jh-elec/SuperClokk/READ_ME!!!.jpg

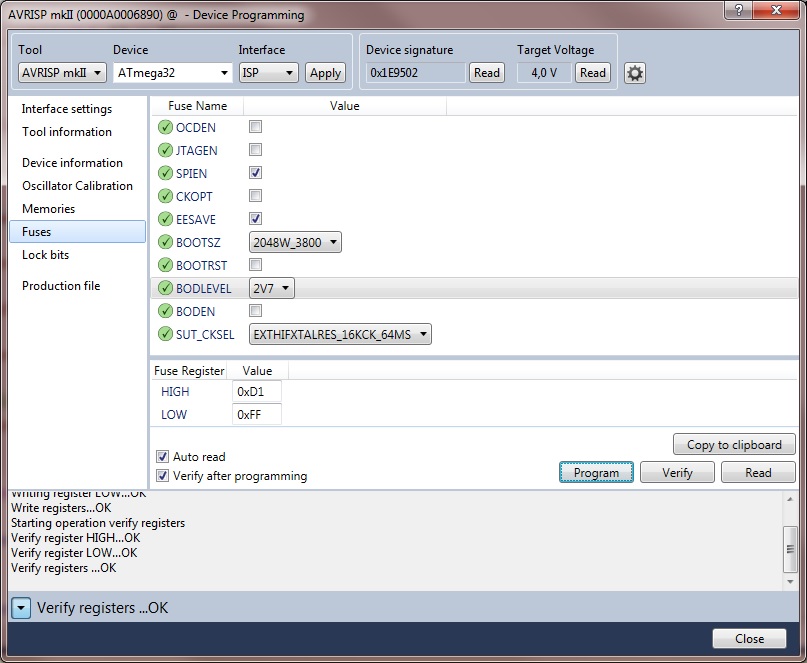
READ_ME!!!.jpg
