jh-elec/SuperClokk/super_clokk/Praesentation/SuperClokk_Front_Board_Screenshot.jpg

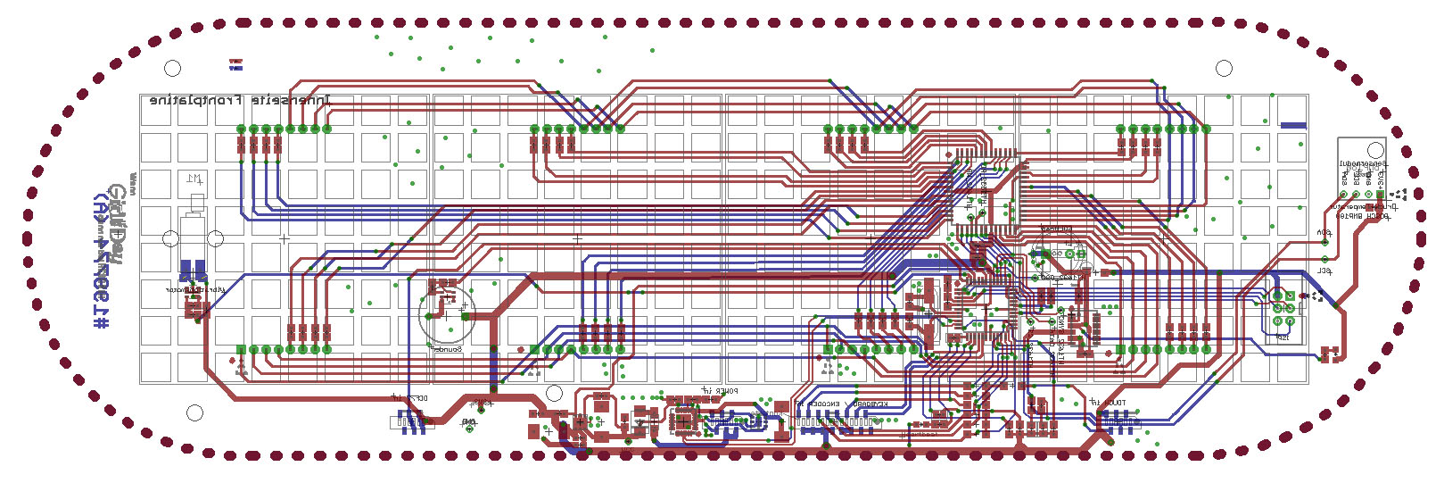
super_clokk/Praesentation/SuperClokk_Front_Board_Screenshot.jpg
