jh-elec/SuperClokk/README.md

# SuperClokk
   8 x 8 LED Matrix Uhr
 
 - BMP180  ( Luftdruck / Temperatur )
 - RX8564  ( RTC - Echtzeituhr )
 - DCF77   ( Uhrzeit  Funkempfänger )
