jh-elec/SuperClokk/super_clokk/CAD Daten/Super_Clokk_199774_2015_03_30.brd

## EAGLE design super_clokk/CAD Daten/Super_Clokk_199774_2015_03_30.brd (2018-07-22)

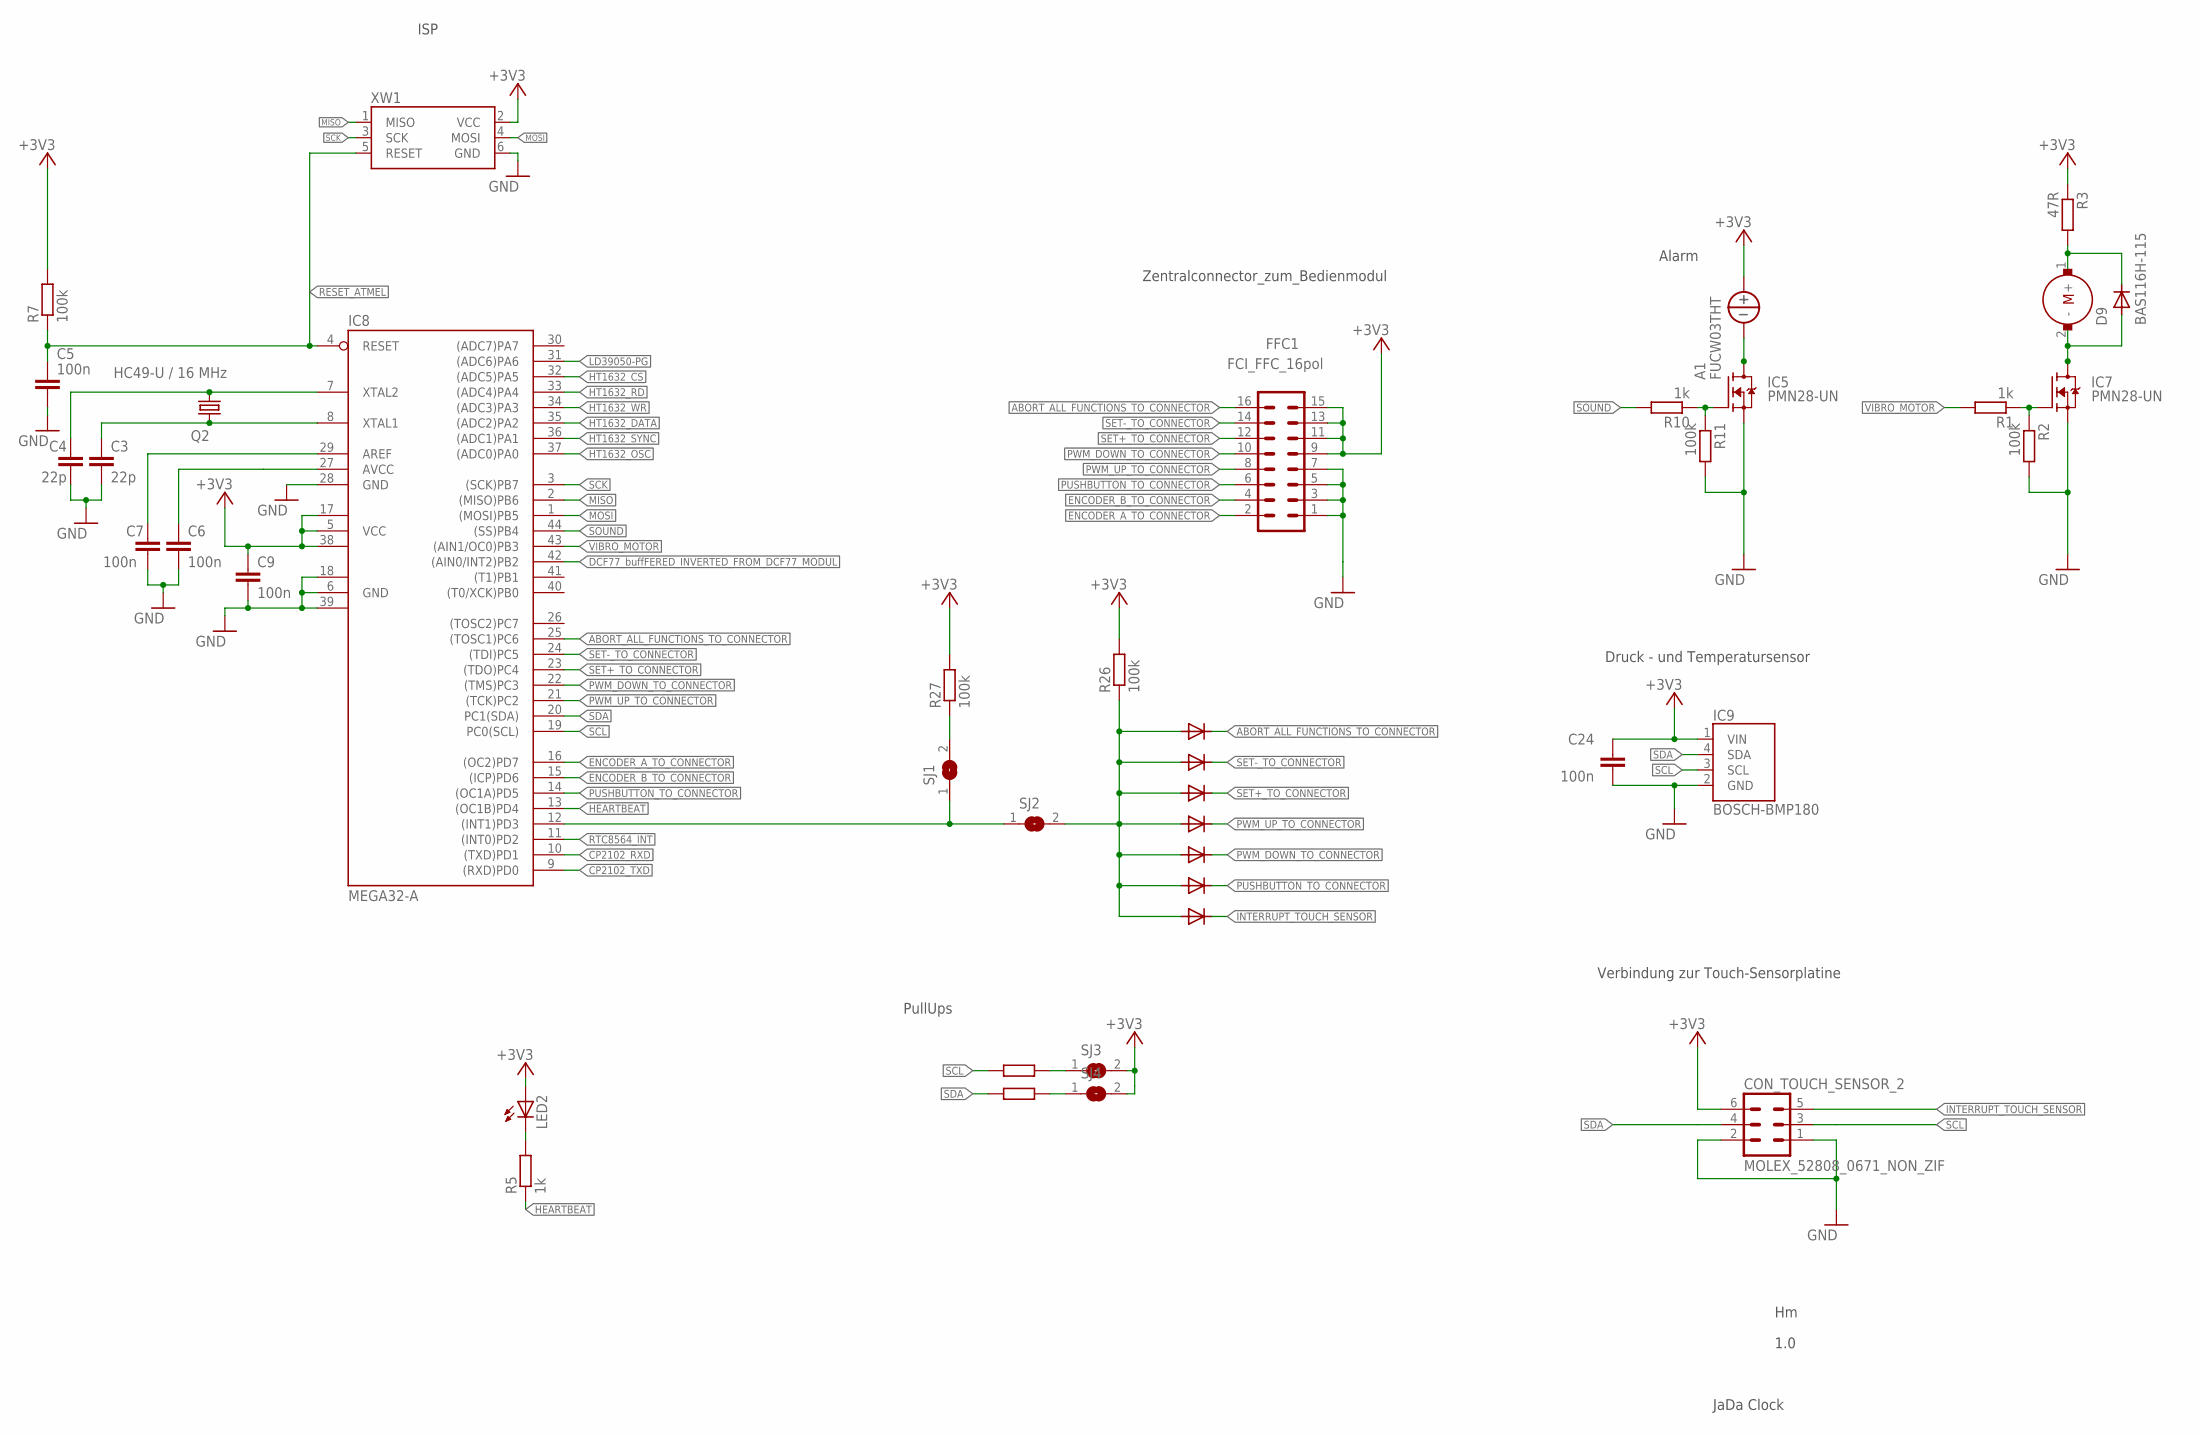
[picture p4: schematic Super_Clokk_199774_2015_03_30.sch, sheet 2]

Parts:
A1: FUCW03THT; FUCW03
C3, C4: 22p; C0805K
C5, C6, C7, C9, C24: 100n; C0805
CON_TOUCH_SENSOR_2: MOLEX_52808_0671_NON_ZIF; MOLEX_52808-0671_NON_ZIF
D2, D3, D4, D5, D6, D8, D9, D10: BAS116H-115; SOD123
FFC1: FCI_FFC_16pol; MOLEX_52808_1671_NON_ZIF
IC5, IC7: PMN28-UN; SOT457
IC8: MEGA32-A; TQFP44
IC9: BOSCH-BMP180; 10X13MM
LED2: LEDCHIPLED_0805; CHIPLED_0805
M1: VIBROMOTORTHT432A; LA4-432A
Q2: HC49-U / 16 MHz; HC49
R1, R5, R10: 1k; R0805
R2, R7, R11, R26, R27: 100k; R0805
R3: 47R; R0805
R52, R53: 4,7k; R0805
SJ1, SJ2, SJ3, SJ4: SJ
XW1: WSL6; WSL

Connections:
+3V3: A1.+, C9.1, C24.1, CON_TOUCH_SENSOR_2.6, FFC1.9, FFC1.11, FFC1.13, FFC1.15, IC8.5 (VCC), IC8.17 (VCC1), IC8.38 (VCC2), IC9.1 (VIN), LED2.A, R3.1, R7.2, R26.2, R27.2, SJ3.2, SJ4.2, XW1.2 (VCC); also elsewhere on the board
ABORT_ALL_FUNCTIONS_TO_CONNECTOR: D2.C, FFC1.16, IC8.25 ((TOSC1)PC6)
AREF: C7.1, IC8.29 (AREF)
AVCC: C6.1, IC8.27 (AVCC)
CP2102_RXD: IC8.10 ((TXD)PD1); also elsewhere on the board
CP2102_TXD: IC8.9 ((RXD)PD0); also elsewhere on the board
DCF77_buffFERED_INVERTED_FROM_DCF77_MODUL: IC8.42 ((AIN0/INT2)PB2); also elsewhere on the board
EINGABE?: D2.A, D3.A, D4.A, D5.A, D6.A, D8.A, D10.A, R26.1, SJ2.2
ENCODER_A_TO_CONNECTOR: FFC1.2, IC8.16 ((OC2)PD7)
ENCODER_B_TO_CONNECTOR: FFC1.4, IC8.15 ((ICP)PD6)
GND: C3.2, C4.2, C5.2, C6.2, C7.2, C9.2, C24.2, CON_TOUCH_SENSOR_2.1, CON_TOUCH_SENSOR_2.2, FFC1.1, FFC1.3, FFC1.5, FFC1.7, IC5.4 (S), IC7.4 (S), IC8.6 (GND), IC8.18 (GND1), IC8.28 (GND), IC8.39 (GND2), IC9.2 (GND), R2.2, R11.2, XW1.6 (GND); also elsewhere on the board
HEARTBEAT: IC8.13 ((OC1B)PD4), R5.1
HT1632_CS: IC8.32 ((ADC5)PA5); also elsewhere on the board
HT1632_DATA: IC8.35 ((ADC2)PA2); also elsewhere on the board
HT1632_OSC: IC8.37 ((ADC0)PA0); also elsewhere on the board
HT1632_RD: IC8.33 ((ADC4)PA4); also elsewhere on the board
HT1632_SYNC: IC8.36 ((ADC1)PA1); also elsewhere on the board
HT1632_WR: IC8.34 ((ADC3)PA3); also elsewhere on the board
INTERRUPT_TOUCH_SENSOR: CON_TOUCH_SENSOR_2.5, D8.C
LD39050-PG: IC8.31 ((ADC6)PA6); also elsewhere on the board
MISO: IC8.2 ((MISO)PB6), XW1.1 (MISO)
MOSI: IC8.1 ((MOSI)PB5), XW1.4 (MOSI)
unnamed: A1.-, IC5.1 (D), IC5.2 (D), IC5.5 (D), IC5.6 (D)
unnamed: R52.2, SJ3.1
unnamed: R53.2, SJ4.1
unnamed: IC7.3 (G), R1.1, R2.1
unnamed: D9.A, IC7.1 (D), IC7.2 (D), IC7.5 (D), IC7.6 (D), M1.2 (-)
unnamed: D9.C, M1.1 (+), R3.2
unnamed: IC5.3 (G), R10.1, R11.1
unnamed: LED2.C, R5.2
unnamed: IC8.12 ((INT1)PD3), SJ1.1, SJ2.1
unnamed: R27.1, SJ1.2
PUSHBUTTON_TO_CONNECTOR: D6.C, FFC1.6, IC8.14 ((OC1A)PD5)
PWM_DOWN_TO_CONNECTOR: D10.C, FFC1.10, IC8.22 ((TMS)PC3)
PWM_UP_TO_CONNECTOR: D5.C, FFC1.8, IC8.21 ((TCK)PC2)
RESET_ATMEL: C5.1, IC8.4 (RESET), R7.1, XW1.5 (RESET)
RTC8564_INT: IC8.11 ((INT0)PD2); also elsewhere on the board
SCK: IC8.3 ((SCK)PB7), XW1.3 (SCK)
SCL: CON_TOUCH_SENSOR_2.3, IC8.19 (PC0(SCL)), IC9.3 (SCL), R52.1; also elsewhere on the board
SDA: CON_TOUCH_SENSOR_2.4, IC8.20 (PC1(SDA)), IC9.4 (SDA), R53.1; also elsewhere on the board
SET+_TO_CONNECTOR: D4.C, FFC1.12, IC8.23 ((TDO)PC4)
SET-_TO_CONNECTOR: D3.C, FFC1.14, IC8.24 ((TDI)PC5)
SOUND: IC8.44 ((SS)PB4), R10.2
VIBRO_MOTOR: IC8.43 ((AIN1/OC0)PB3), R1.2
XTAL_1: C3.1, IC8.8 (XTAL1), Q2.1
XTAL_2: C4.1, IC8.7 (XTAL2), Q2.2

Notes on the sheet:
1.0
JaDa Clock
Alarm
PullUps
Druck - und Temperatursensor
ISP
Zentralconnector_zum_Bedienmodul
Verbindung zur Touch-Sensorplatine

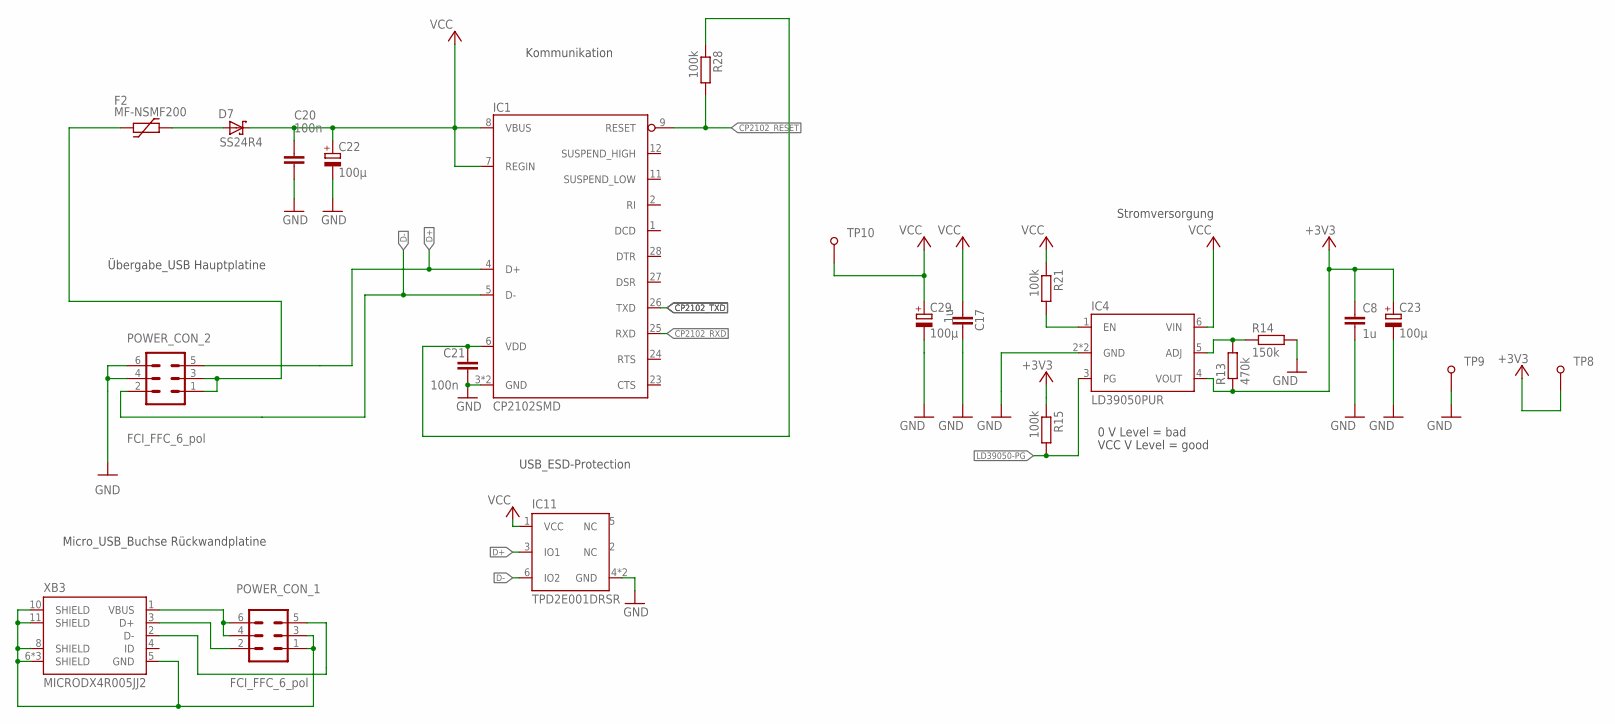
[picture p5: schematic Super_Clokk_199774_2015_03_30.sch, sheet 3]

Parts:
C8, C17: 1u; C0805K
C20, C21: 100n; C0805
C22, C23, C29: 100µ; SMC_D
D7: SS24R4; DO-214AA/SMB
F2: MF-NSMF200; 1206L
IC1: CP2102SMD; QFN28
IC4: LD39050PUR; DFN6
IC11: TPD2E001DRSR; DRS
POWER_CON_1, POWER_CON_2: FCI_FFC_6_pol; MOLEX_52808-0671_NON_ZIF
R13: 470k; R0603
R14: 150k; R0603
R15, R21, R28: 100k; R0805
TP8, TP9, TP10: PAD´S8; THT-1X2,54
XB3: MICRODX4R005JJ2; MICRO_NEU

Connections:
+3V3: C8.1, C23.+, IC4.4 (VOUT), R13.1, R15.1, TP8.TP; also elsewhere on the board
CP2102_RESET: IC1.9 (RESET), R28.2
CP2102_RXD: IC1.25 (RXD); also elsewhere on the board
CP2102_TXD: IC1.26 (TXD); also elsewhere on the board
D+: IC1.4 (D+), IC11.3 (IO1), POWER_CON_2.5
D-: IC1.5 (D-), IC11.6 (IO2), POWER_CON_2.2
GND: C8.2, C17.2, C20.2, C21.2, C22.-, C23.-, C29.-, IC1.3 (GND), IC1.THERMAL (GND), IC4.2 (GND), IC4.EXP (GND), IC11.4 (GND), IC11.THERMAL (GND), POWER_CON_2.4, POWER_CON_2.6, R14.2, TP9.TP; also elsewhere on the board
GND_USB_RüCKWAND: POWER_CON_1.1, POWER_CON_1.3, XB3.5 (GND), XB3.6 (SHIELD), XB3.7 (SHIELD), XB3.8 (SHIELD), XB3.9 (SHIELD), XB3.10 (SHIELD), XB3.11 (SHIELD)
LD39050-PG: IC4.3 (PG), R15.2; also elsewhere on the board
unnamed: C21.1, IC1.6 (VDD), R28.1
unnamed: D7.A, F2.2
unnamed: IC4.1 (EN), R21.2
unnamed: IC4.5 (ADJ), R13.2, R14.1
POWER_FROM_USB_RüCKWAND: F2.1, POWER_CON_2.1, POWER_CON_2.3
USB_D+: POWER_CON_1.2, XB3.3 (D+)
USB_D-: POWER_CON_1.5, XB3.2 (D-)
VBUS_USB_RüCKWAND: POWER_CON_1.4, POWER_CON_1.6, XB3.1 (VBUS)
VCC: C17.1, C20.1, C22.+, C29.+, D7.C, IC1.7 (REGIN), IC1.8 (VBUS), IC4.6 (VIN), IC11.1 (VCC), R21.1, TP10.TP

Notes on the sheet:
Kommunikation
0 V Level = bad
VCC V Level = good
Stromversorgung
USB_ESD-Protection
Micro_USB_Buchse Rückwandplatine
Übergabe_USB Hauptplatine

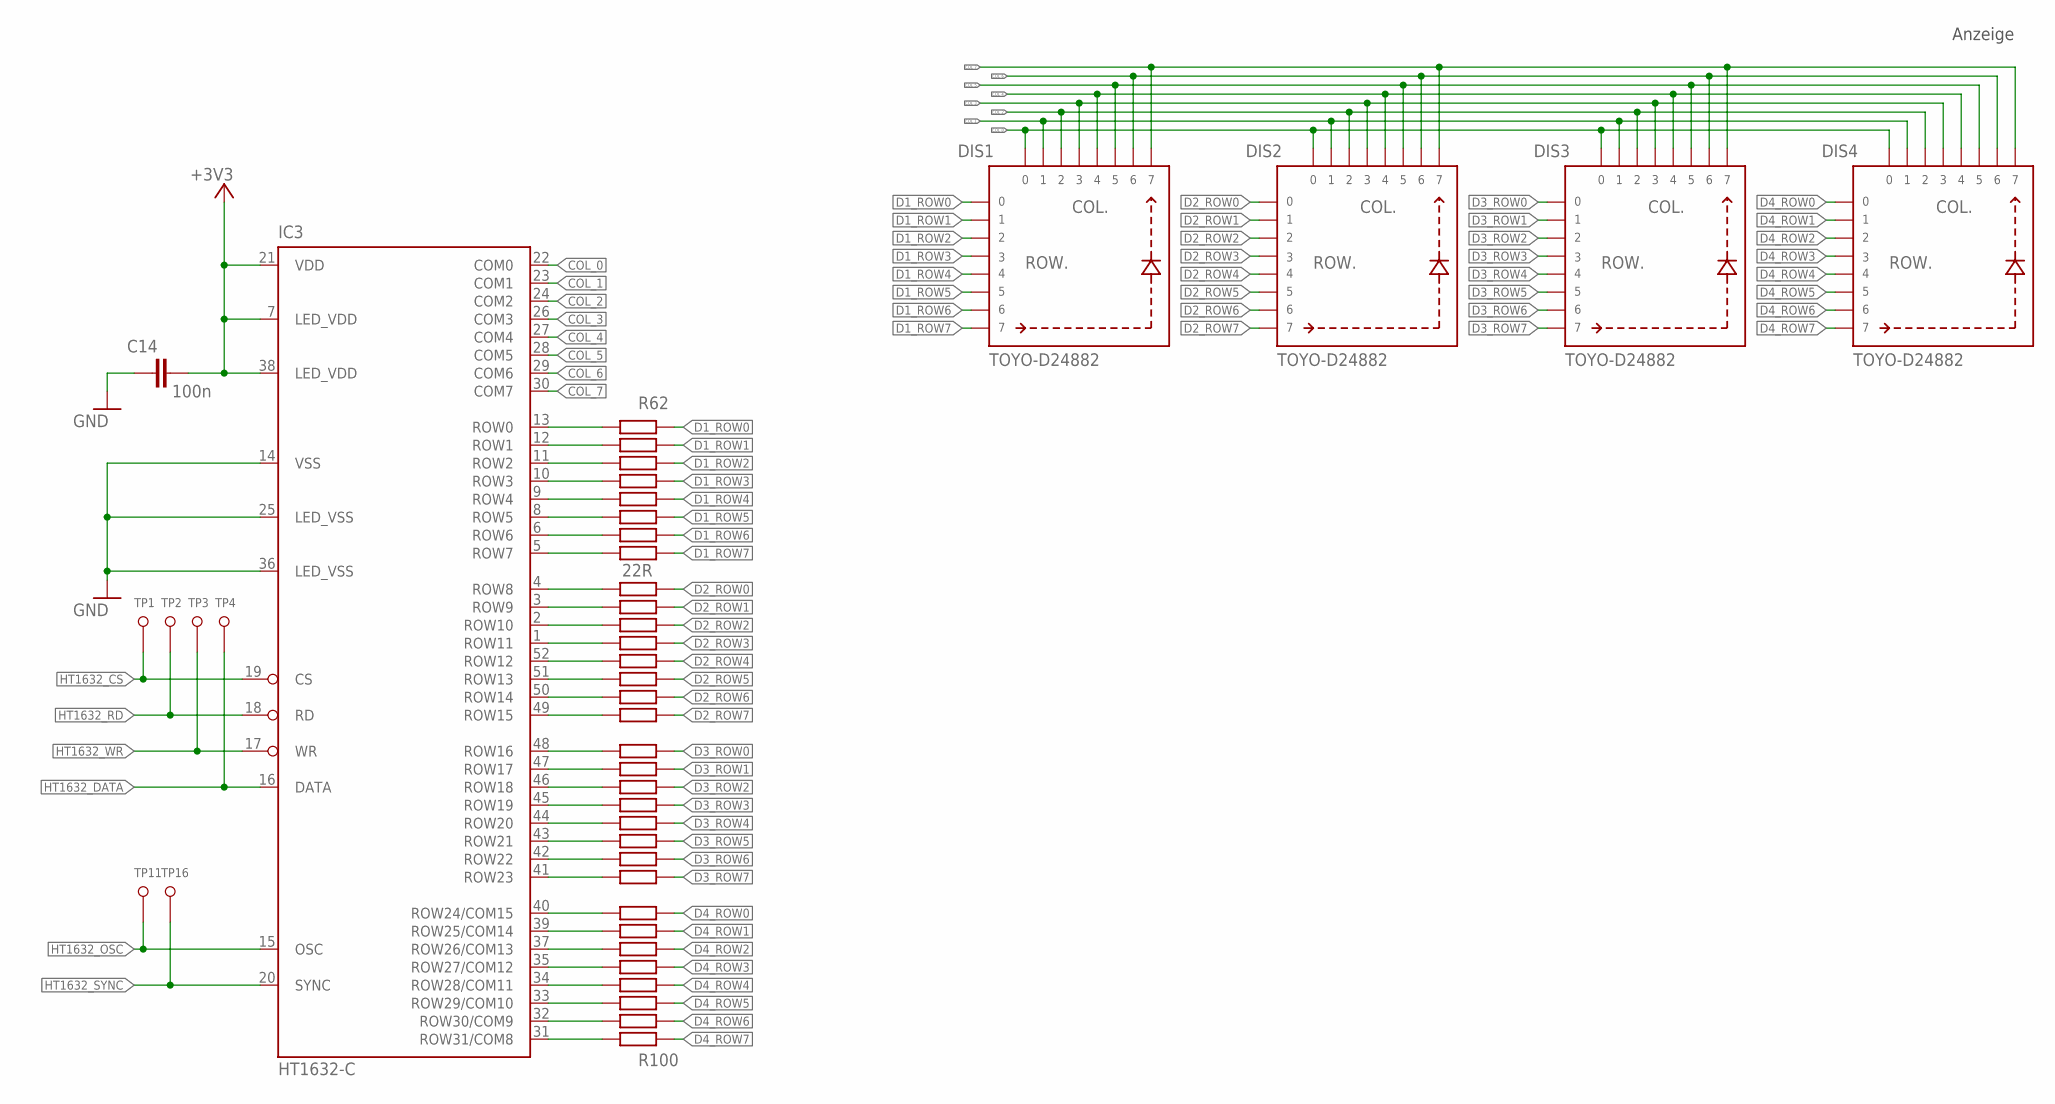
[picture p6: schematic Super_Clokk_199774_2015_03_30.sch, sheet 4]

Parts:
C14: 100n; C0805
DIS1, DIS2, DIS3, DIS4: TOYO-D24882; TOYO
IC3: HT1632-C; 52PIN_OFP
R62, R63, R65, R66, R67, R74, R75, R76, R77, R78, R79, R80, R81, R82, R83, R84, R85, R86, R87, R88, R89, R90, R91, R92, R93, R94, R95, R96, R97, R98, R99, R100: 22R; R0805
TP1, TP2, TP3, TP4, TP11, TP16: PAD´S8; THT-1X2,54

Connections:
+3V3: C14.2, IC3.7 (LED_VDD), IC3.21 (VDD), IC3.38 (LED_VDD); also elsewhere on the board
COL_0: DIS1.1, DIS2.1, DIS3.1, DIS4.1, IC3.22 (COM0)
COL_1: DIS1.2, DIS2.2, DIS3.2, DIS4.2, IC3.23 (COM1)
COL_2: DIS1.3, DIS2.3, DIS3.3, DIS4.3, IC3.24 (COM2)
COL_3: DIS1.4, DIS2.4, DIS3.4, DIS4.4, IC3.26 (COM3)
COL_4: DIS1.12, DIS2.12, DIS3.12, DIS4.12, IC3.27 (COM4)
COL_5: DIS1.11, DIS2.11, DIS3.11, DIS4.11, IC3.28 (COM5)
COL_6: DIS1.10, DIS2.10, DIS3.10, DIS4.10, IC3.29 (COM6)
COL_7: DIS1.9, DIS2.9, DIS3.9, DIS4.9, IC3.30 (COM7)
D1_ROW0: DIS1.16, R62.1
D1_ROW1: DIS1.15, R63.1
D1_ROW2: DIS1.14, R65.1
D1_ROW3: DIS1.13, R66.1
D1_ROW4: DIS1.5, R67.1
D1_ROW5: DIS1.6, R74.1
D1_ROW6: DIS1.7, R75.1
D1_ROW7: DIS1.8, R76.1
D2_ROW0: DIS2.16, R77.1
D2_ROW1: DIS2.15, R78.1
D2_ROW2: DIS2.14, R79.1
D2_ROW3: DIS2.13, R80.1
D2_ROW4: DIS2.5, R81.1
D2_ROW5: DIS2.6, R82.1
D2_ROW6: DIS2.7, R83.1
D2_ROW7: DIS2.8, R84.1
D3_ROW0: DIS3.16, R85.1
D3_ROW1: DIS3.15, R86.1
D3_ROW2: DIS3.14, R87.1
D3_ROW3: DIS3.13, R88.1
D3_ROW4: DIS3.5, R89.1
D3_ROW5: DIS3.6, R90.1
D3_ROW6: DIS3.7, R91.1
D3_ROW7: DIS3.8, R92.1
D4_ROW0: DIS4.16, R93.1
D4_ROW1: DIS4.15, R94.1
D4_ROW2: DIS4.14, R95.1
D4_ROW3: DIS4.13, R96.1
D4_ROW4: DIS4.5, R97.1
D4_ROW5: DIS4.6, R98.1
D4_ROW6: DIS4.7, R99.1
D4_ROW7: DIS4.8, R100.1
GND: C14.1, IC3.14 (VSS), IC3.25 (LED_VSS), IC3.36 (LED_VSS); also elsewhere on the board
HT1632_CS: IC3.19 (CS), TP1.TP; also elsewhere on the board
HT1632_DATA: IC3.16 (DATA), TP4.TP; also elsewhere on the board
HT1632_OSC: IC3.15 (OSC), TP11.TP; also elsewhere on the board
HT1632_RD: IC3.18 (RD), TP2.TP; also elsewhere on the board
HT1632_SYNC: IC3.20 (SYNC), TP16.TP; also elsewhere on the board
HT1632_WR: IC3.17 (WR), TP3.TP; also elsewhere on the board
unnamed: IC3.13 (ROW0), R62.2
unnamed: IC3.12 (ROW1), R63.2
unnamed: IC3.11 (ROW2), R65.2
unnamed: IC3.10 (ROW3), R66.2
unnamed: IC3.9 (ROW4), R67.2
unnamed: IC3.8 (ROW5), R74.2
unnamed: IC3.6 (ROW6), R75.2
unnamed: IC3.5 (ROW7), R76.2
unnamed: IC3.4 (ROW8), R77.2
unnamed: IC3.3 (ROW9), R78.2
unnamed: IC3.2 (ROW10), R79.2
unnamed: IC3.1 (ROW11), R80.2
unnamed: IC3.52 (ROW12), R81.2
unnamed: IC3.51 (ROW13), R82.2
unnamed: IC3.50 (ROW14), R83.2
unnamed: IC3.49 (ROW15), R84.2
unnamed: IC3.48 (ROW16), R85.2
unnamed: IC3.47 (ROW17), R86.2
unnamed: IC3.46 (ROW18), R87.2
unnamed: IC3.45 (ROW19), R88.2
unnamed: IC3.44 (ROW20), R89.2
unnamed: IC3.43 (ROW21), R90.2
unnamed: IC3.42 (ROW22), R91.2
unnamed: IC3.41 (ROW23), R92.2
unnamed: IC3.40 (ROW24/COM15), R93.2
unnamed: IC3.39 (ROW25/COM14), R94.2
unnamed: IC3.37 (ROW26/COM13), R95.2
unnamed: IC3.35 (ROW27/COM12), R96.2
unnamed: IC3.34 (ROW28/COM11), R97.2
unnamed: IC3.33 (ROW29/COM10), R98.2
unnamed: IC3.32 (ROW30/COM9), R99.2
unnamed: IC3.31 (ROW31/COM8), R100.2

Notes on the sheet:
Anzeige

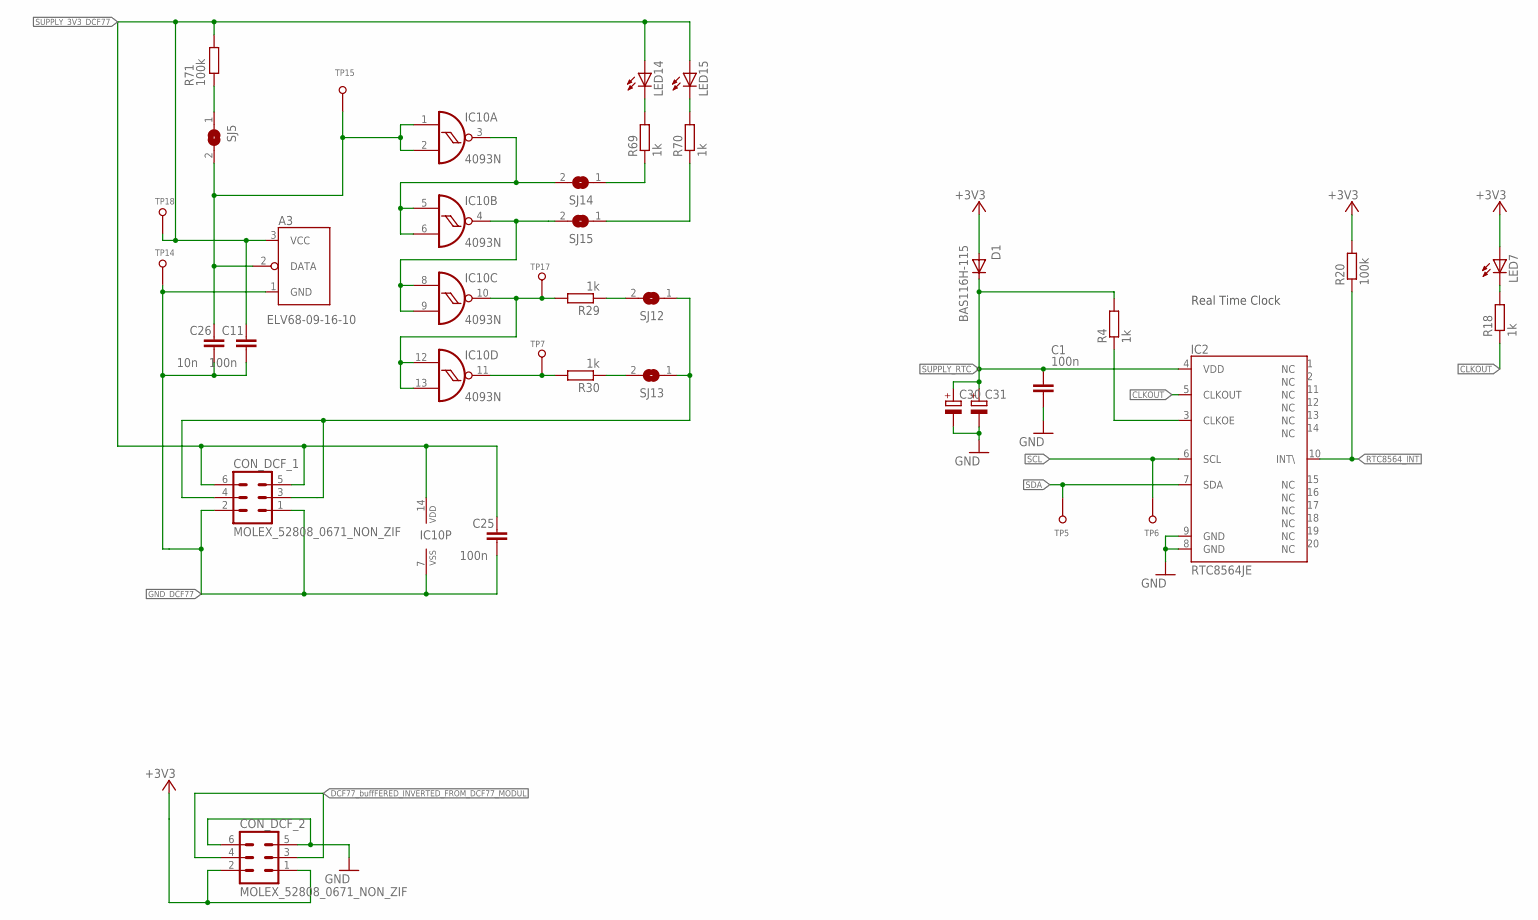
[picture p7: schematic Super_Clokk_199774_2015_03_30.sch, sheet 5]

Parts:
A3: ELV68-09-16-10; 18X23MM
C1, C11, C25: 100n; C0805
C26: 10n; C0805
C30: PANASONIC-EN&SD-SERIESTHT_1; PANASONIC_SD_SERIES_STEHEND
C31: PANASONIC-EN&SD-SERIESTHT; PANASONIC_SD_SERIES_LIEGEND
CON_DCF_1, CON_DCF_2: MOLEX_52808_0671_NON_ZIF; MOLEX_52808-0671_NON_ZIF
D1: BAS116H-115; SOD123
IC2: RTC8564JESMD; VSOJ20
IC10: 4093N; DIL14
LED7, LED14, LED15: LEDCHIPLED_0805; CHIPLED_0805
R4, R18, R29, R30, R69, R70: 1k; R0805
R20, R71: 100k; R0805
SJ5, SJ12, SJ13, SJ14, SJ15: SJ
TP5, TP6, TP7, TP14, TP15, TP17, TP18: PAD´S8; THT-1X2,54

Connections:
+3V3: CON_DCF_2.1, CON_DCF_2.2, D1.A, LED7.A, R20.2; also elsewhere on the board
CLKOUT: IC2.5 (CLKOUT), R18.1
DCF77_MODUL_OUT_INVERTED: A3.2 (DATA), C26.1, IC10.1 (I0), IC10.2 (I1), SJ5.2, TP15.TP
DCF77_buffFERED_INVERTED_FROM_DCF77_MODUL: CON_DCF_2.3, CON_DCF_2.4; also elsewhere on the board
DCF77_buffF_INVERTED: IC10.4 (O), IC10.8 (I0), IC10.9 (I1), SJ15.2
DCF77_buffF_NON_INVERTED: IC10.10 (O), IC10.12 (I0), IC10.13 (I1), R29.2, TP17.TP
DCF77_buffF_OUT_SWITCHABLE: CON_DCF_1.3, CON_DCF_1.4, SJ12.1, SJ13.1
GND: C1.2, C30.-, C31.MINUS (-), CON_DCF_2.5, CON_DCF_2.6, IC2.8 (GND), IC2.9 (GND); also elsewhere on the board
GND_DCF77: A3.1 (GND), C11.2, C25.2, C26.2, CON_DCF_1.1, CON_DCF_1.2, IC10.7 (VSS), TP14.TP
unnamed: R71.2, SJ5.1
unnamed: IC2.3 (CLKOE), R4.1
unnamed: IC10.3 (O), IC10.5 (I0), IC10.6 (I1), SJ14.2
unnamed: LED7.C, R18.2
unnamed: IC10.11 (O), R30.2, TP7.TP
unnamed: R29.1, SJ12.2
unnamed: R30.1, SJ13.2
unnamed: R69.1, SJ14.1
unnamed: R70.1, SJ15.1
unnamed: LED14.C, R69.2
unnamed: LED15.C, R70.2
RTC8564_INT: IC2.10 (INT\), R20.1; also elsewhere on the board
SCL: IC2.6 (SCL), TP6.TP; also elsewhere on the board
SDA: IC2.7 (SDA), TP5.TP; also elsewhere on the board
SUPPLY_3V3_DCF77: A3.3 (VCC), C11.1, C25.1, CON_DCF_1.5, CON_DCF_1.6, IC10.14 (VDD), LED14.A, LED15.A, R71.1, TP18.TP
SUPPLY_RTC: C1.1, C30.+, C31.PLUS (+), D1.C, IC2.4 (VDD), R4.2

Notes on the sheet:
Real Time Clock

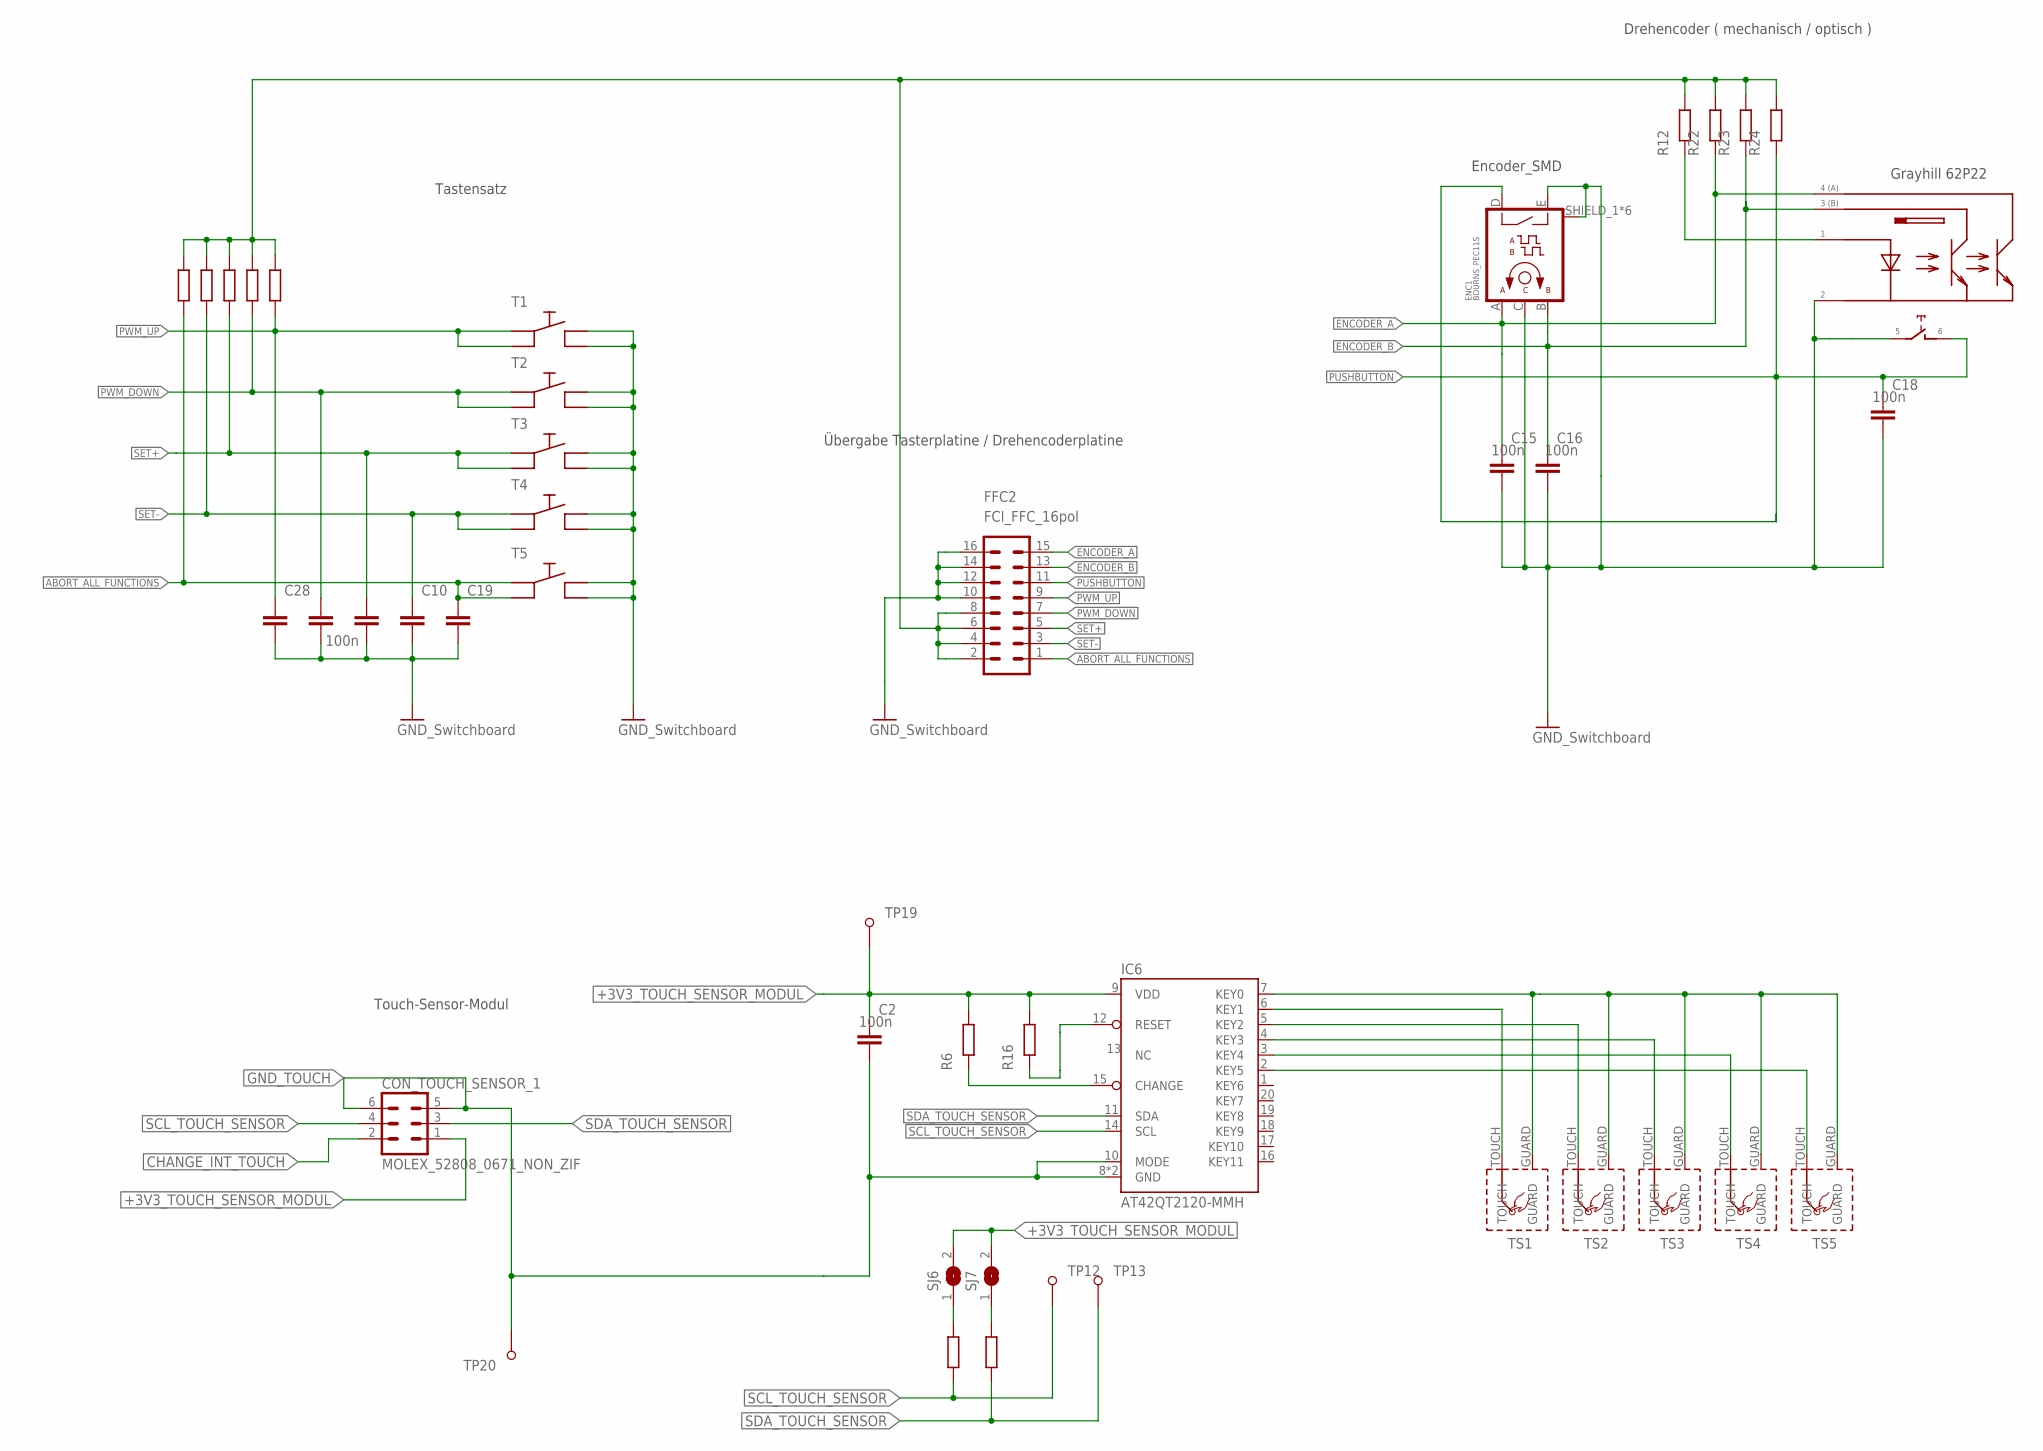
[picture p8: schematic Super_Clokk_199774_2015_03_30.sch, sheet 6]

Parts:
C2, C10, C12, C15, C16, C18, C19, C27, C28: 100n; C0805
CON_TOUCH_SENSOR_1: MOLEX_52808_0671_NON_ZIF; MOLEX_52808-0671_NON_ZIF
ENC1: BOURNS_PEC11S
ENC2: Grayhill 62P22; 62P22
FFC2: FCI_FFC_16pol; MOLEX_52808_1671_NON_ZIF
IC6: AT42QT2120-MMH; VQFN-20
R6, R16, R17, R19, R22, R23, R24: 10k; R0805
R8, R9, R25, R64, R72: 100k; R0805
R12: 100R; R0805
SJ6, SJ7: SJ
T1, T2, T3, T4, T5: OMRON-B3S-1002P; B3S-1002P
TP12, TP13, TP19, TP20: PAD´S8; THT-1X2,54
TS1, TS2, TS3, TS4, TS5: TOUCH_SENSOR_14MM

Connections:
+3V3_TOUCH_SENSOR_MODUL: C2.1, CON_TOUCH_SENSOR_1.1, IC6.9 (VDD), R6.2, R16.2, SJ6.2, SJ7.2, TP19.TP
ABORT_ALL_FUNCTIONS: C19.1, FFC2.1, R25.2, T5.1, T5.2
CHANGE_INT_TOUCH: CON_TOUCH_SENSOR_1.2, IC6.15 (CHANGE), R6.1
ENCODER_A: C15.1, ENC1.A, ENC2.4, FFC2.15, R22.1
ENCODER_B: C16.1, ENC1.B, ENC2.3, FFC2.13, R23.1
GND_SWITCHBOARD: C10.2, C12.2, C15.2, C16.2, C18.2, C19.2, C27.2, C28.2, ENC1.C, ENC1.E, ENC1.SHIELD_1, ENC1.SHIELD_2 (SHIELD_1), ENC1.SHIELD_3 (SHIELD_1), ENC1.SHIELD_4 (SHIELD_1), ENC1.SHIELD_5 (SHIELD_1), ENC1.SHIELD_6 (SHIELD_1), ENC2.2, ENC2.5 (1), FFC2.10, FFC2.12, FFC2.14, FFC2.16, T1.3, T1.4, T2.3, T2.4, T3.3, T3.4, T4.3, T4.4, T5.3, T5.4
GND_TOUCH: C2.2, CON_TOUCH_SENSOR_1.5, CON_TOUCH_SENSOR_1.6, IC6.8 (GND), IC6.10 (MODE), IC6.EXP. (GND), TP20.TP
unnamed: IC6.7 (KEY0), TS1.GUARD, TS2.GUARD, TS3.GUARD, TS4.GUARD, TS5.GUARD
unnamed: ENC2.1, R12.1
unnamed: IC6.12 (RESET), R16.1
unnamed: IC6.6 (KEY1), TS1.TOUCH
unnamed: IC6.5 (KEY2), TS2.TOUCH
unnamed: IC6.4 (KEY3), TS3.TOUCH
unnamed: IC6.3 (KEY4), TS4.TOUCH
unnamed: IC6.2 (KEY5), TS5.TOUCH
unnamed: R17.1, SJ6.1
unnamed: R19.1, SJ7.1
PUSHBUTTON: C18.1, ENC1.D, ENC2.6 (2), FFC2.11, R24.1
PWM_DOWN: C27.1, FFC2.7, R9.2, T2.1, T2.2
PWM_UP: C28.1, FFC2.9, R8.2, T1.1, T1.2
SCL_TOUCH_SENSOR: CON_TOUCH_SENSOR_1.4, IC6.14 (SCL), R17.2, TP12.TP
SDA_TOUCH_SENSOR: CON_TOUCH_SENSOR_1.3, IC6.11 (SDA), R19.2, TP13.TP
SET+: C12.1, FFC2.5, R64.2, T3.1, T3.2
SET-: C10.1, FFC2.3, R72.2, T4.1, T4.2
SUPPLY_3V3_BEDIENMODUL: FFC2.2, FFC2.4, FFC2.6, FFC2.8, R8.1, R9.1, R12.2, R22.2, R23.2, R24.2, R25.1, R64.1, R72.1

Notes on the sheet:
Encoder_SMD
Tastensatz
Übergabe Tasterplatine / Drehencoderplatine
Drehencoder ( mechanisch / optisch )
Touch-Sensor-Modul

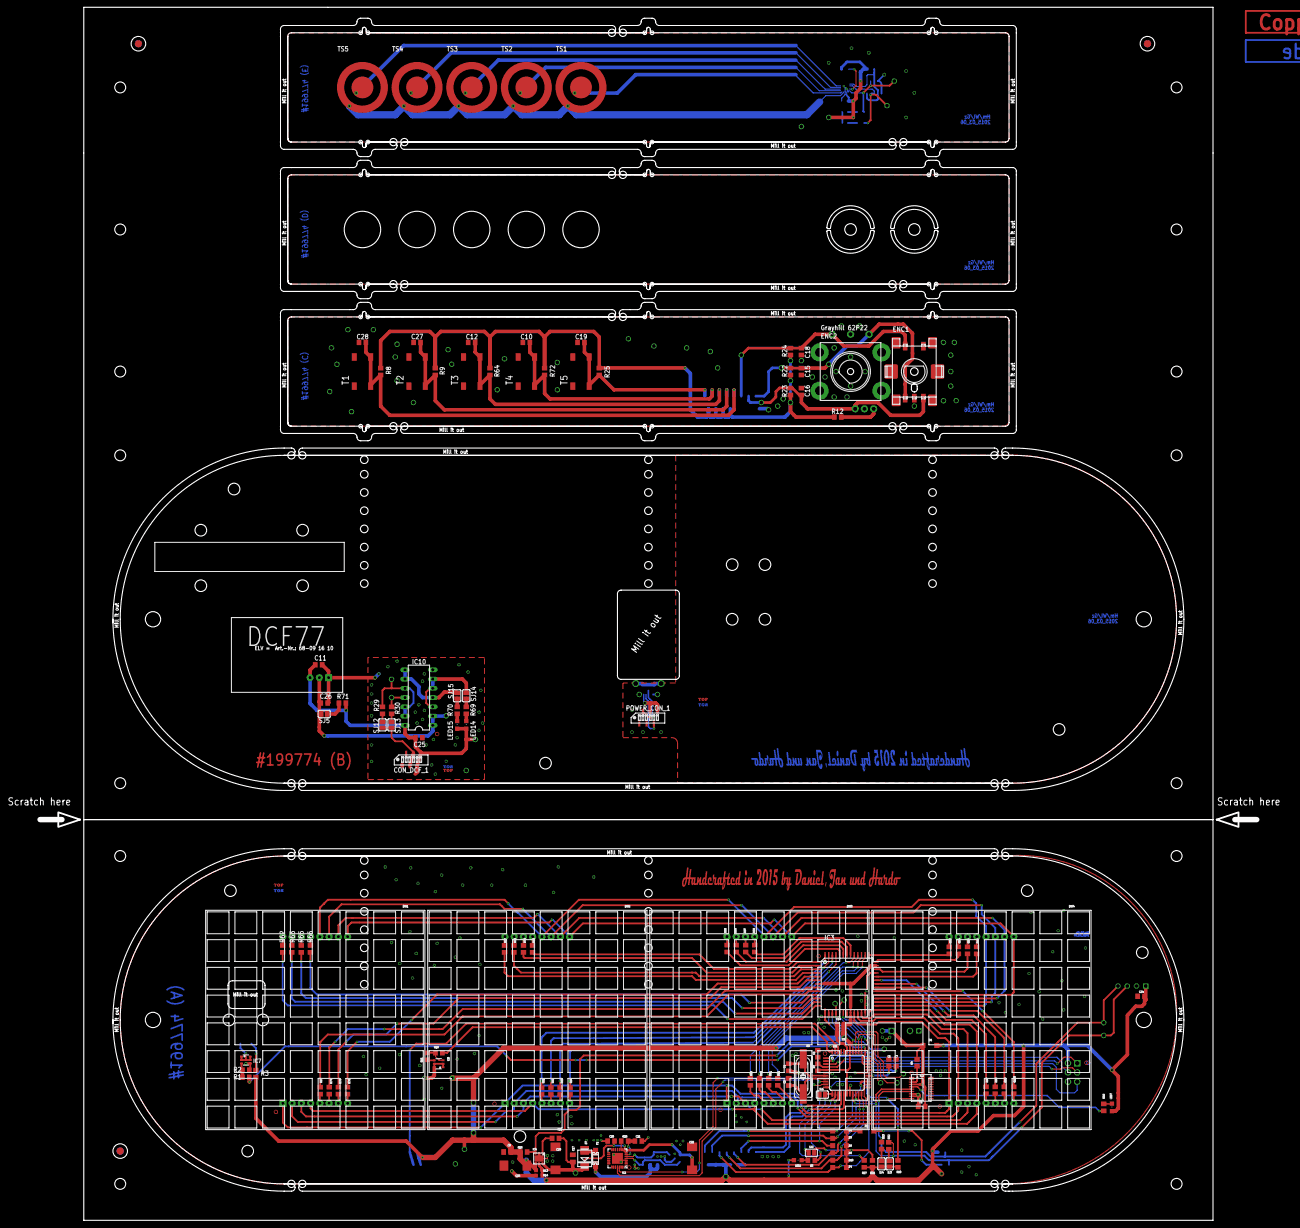
[picture p9: board Super_Clokk_199774_2015_03_30.brd from above]

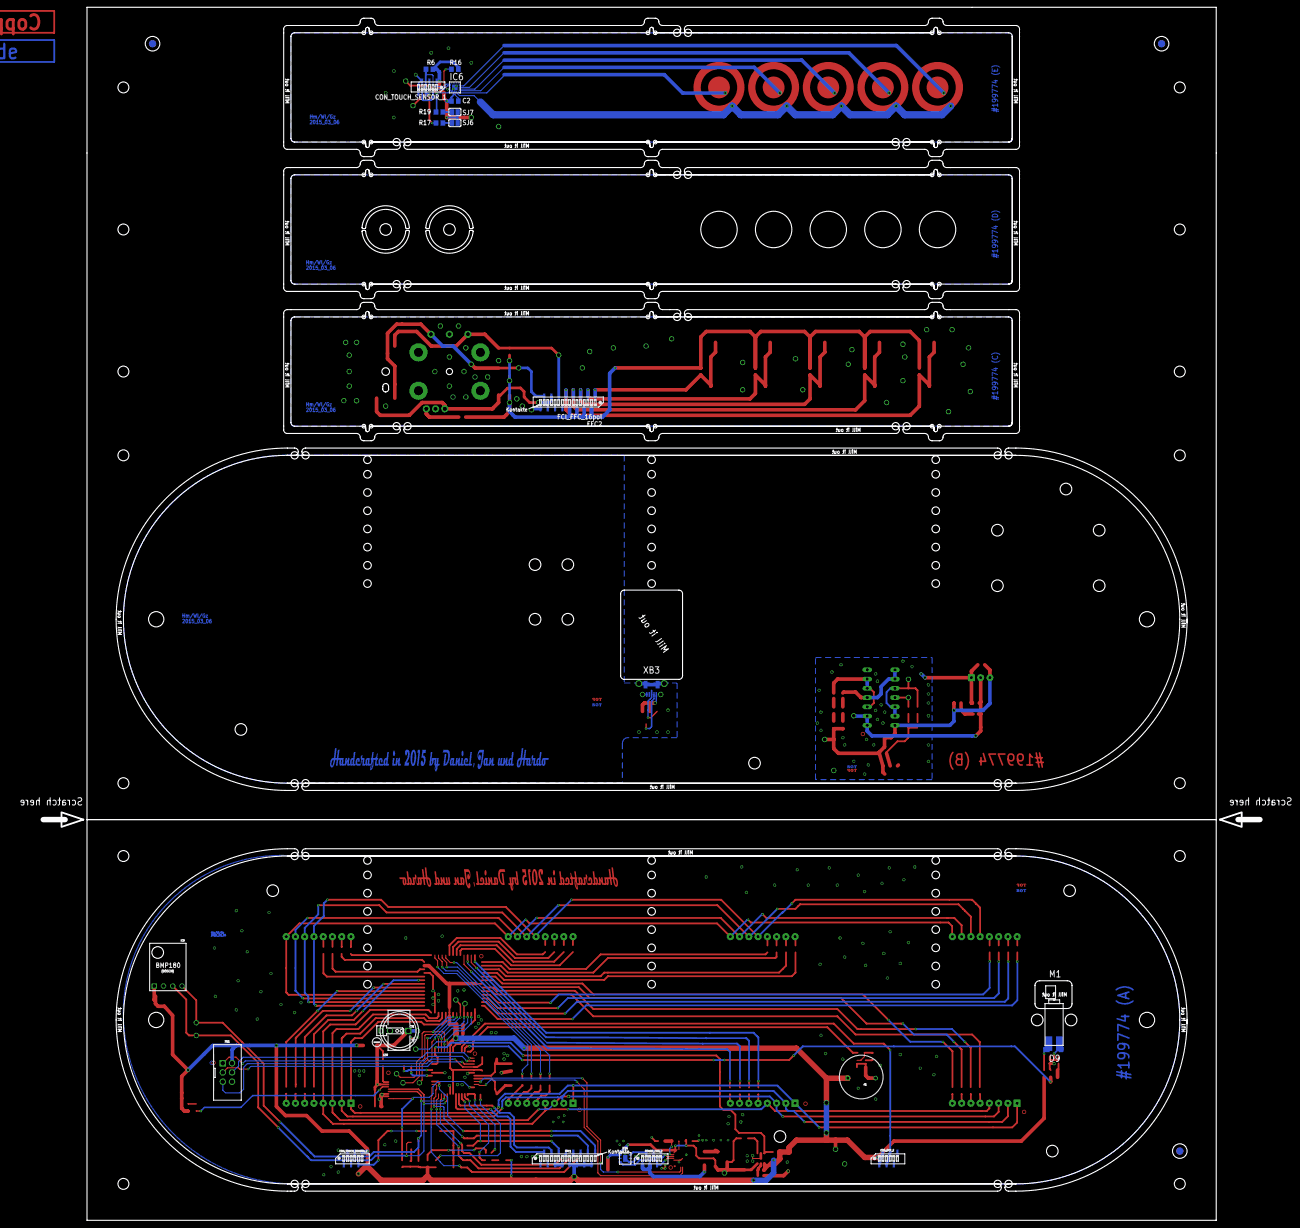
[picture p10: board Super_Clokk_199774_2015_03_30.brd from below]

Board: 2 copper layers, 334.0 x 333.0 mm, 211 parts (28 on the bottom side), 175 nets.

Other parts of the board:
MAINFRAME: PLATINENKONTUR_310X220_FULLY_ROUNDED
REF1, REF2, REF3: PASSER_2MM
U$1, U$6, U$8: BOT
U$2, U$9: HANDCRAFTED_WL_HM_GZ
U$3, U$4, U$5: TOP
U$7, U$24: WENN_GIRLSDAY_DANN_NUR_BEI_HESCH_LAYER_2
U$10, U$11, U$13: BESCHRIFTUNG_MECHANISCHE_TASTEN
U$12: WENN_GIRLSDAY_DANN_NUR_BEI_HESCH_LAYER_15
U$17, U$21, U$22, U$23: HESCH_LOGO_BIENE_LAYER_15
U$18, U$19, U$20: HESCH_LOGO_BIENE_LAYER_2
