jh-elec/SuperClokk/super_clokk/5x8font.h

const char font_0 [] PROGMEM = { ' ', 3, 0x00, 0x00, 0x00, 0x00, 0x00}; // " "
const char font_1 [] PROGMEM = { 'A', 5, 0x3F, 0x48, 0x88, 0x48, 0x3F}; //  A
const char font_2 [] PROGMEM = { 'B', 5, 0xFF, 0x91, 0x91, 0x91, 0x6E}; //  B
const char font_3 [] PROGMEM = { 'C', 5, 0x7E, 0x81, 0x81, 0x81, 0x42}; //  C
const char font_4 [] PROGMEM = { 'D', 5, 0xFF, 0x81, 0x81, 0x42, 0x3C}; //  D
const char font_5 [] PROGMEM = { 'E', 5, 0xFF, 0x91, 0x91, 0x91, 0x81}; //  E
const char font_6 [] PROGMEM = { 'F', 5, 0xFF, 0x90, 0x90, 0x90, 0x80}; //  F
const char font_7 [] PROGMEM = { 'G', 5, 0x7E, 0x81, 0x89, 0x89, 0x4E}; //  G
const char font_8 [] PROGMEM = { 'H', 5, 0xFF, 0x10, 0x10, 0x10, 0xFF}; //  H
const char font_9 [] PROGMEM = { 'I', 5, 0x81, 0x81, 0xFF, 0x81, 0x81}; //  I
const char font_10[] PROGMEM = { 'J', 5, 0x06, 0x01, 0x01, 0x01, 0xFE}; //  J
const char font_11[] PROGMEM = { 'K', 5, 0xFF, 0x18, 0x24, 0x42, 0x81}; //  K
const char font_12[] PROGMEM = { 'L', 5, 0xFF, 0x01, 0x01, 0x01, 0x01}; //  L
const char font_13[] PROGMEM = { 'M', 5, 0xFF, 0x40, 0x30, 0x40, 0xFF}; //  M
const char font_14[] PROGMEM = { 'N', 5, 0xFF, 0x40, 0x30, 0x08, 0xFF}; //  N
const char font_15[] PROGMEM = { 'O', 5, 0x7E, 0x81, 0x81, 0x81, 0x7E}; //  O
const char font_16[] PROGMEM = { 'P', 5, 0xFF, 0x88, 0x88, 0x88, 0x70}; //  P
const char font_17[] PROGMEM = { 'Q', 5, 0x7E, 0x81, 0x85, 0x82, 0x7D}; //  Q
const char font_18[] PROGMEM = { 'R', 5, 0xFF, 0x88, 0x8C, 0x8A, 0x71}; //  R
const char font_19[] PROGMEM = { 'S', 5, 0x61, 0x91, 0x91, 0x91, 0x8E}; //  S
const char font_20[] PROGMEM = { 'T', 5, 0x80, 0x80, 0xFF, 0x80, 0x80}; //  T
const char font_21[] PROGMEM = { 'U', 5, 0xFE, 0x01, 0x01, 0x01, 0xFE}; //  U
const char font_22[] PROGMEM = { 'V', 5, 0xF0, 0x0C, 0x03, 0x0C, 0xF0}; //  V
const char font_23[] PROGMEM = { 'W', 5, 0xFF, 0x02, 0x0C, 0x02, 0xFF}; //  W
const char font_24[] PROGMEM = { 'X', 5, 0xC3, 0x24, 0x18, 0x24, 0xC3}; //  X
const char font_25[] PROGMEM = { 'Y', 5, 0xE0, 0x10, 0x0F, 0x10, 0xE0}; //  Y
const char font_26[] PROGMEM = { 'Z', 5, 0x83, 0x85, 0x99, 0xA1, 0xC1}; //  Z
const char font_27[] PROGMEM = { 'a', 5, 0x06, 0x29, 0x29, 0x29, 0x1F}; //  a
const char font_28[] PROGMEM = { 'b', 5, 0xFF, 0x09, 0x11, 0x11, 0x0E}; //  b
const char font_29[] PROGMEM = { 'c', 5, 0x1E, 0x21, 0x21, 0x21, 0x12}; //  c
const char font_30[] PROGMEM = { 'd', 5, 0x0E, 0x11, 0x11, 0x09, 0xFF}; //  d
const char font_31[] PROGMEM = { 'e', 5, 0x0E, 0x15, 0x15, 0x15, 0x0C}; //  e
const char font_32[] PROGMEM = { 'f', 5, 0x08, 0x7F, 0x88, 0x80, 0x40}; //  f
const char font_33[] PROGMEM = { 'g', 5, 0x30, 0x49, 0x49, 0x49, 0x7E}; //  g
const char font_34[] PROGMEM = { 'h', 5, 0xFF, 0x08, 0x10, 0x10, 0x0F}; //  h
const char font_35[] PROGMEM = { 'i', 1, 0x5F, 0x00, 0x00, 0x00, 0x00}; //  i
const char font_36[] PROGMEM = { 'j', 4, 0x02, 0x01, 0x21, 0xBE, 0x00}; //  j
const char font_37[] PROGMEM = { 'k', 4, 0xFF, 0x04, 0x0A, 0x11, 0x00}; //  k
const char font_38[] PROGMEM = { 'l', 4, 0x00, 0x81, 0xFF, 0x01, 0x00}; //  l
const char font_39[] PROGMEM = { 'm', 5, 0x3F, 0x20, 0x18, 0x20, 0x1F}; //  m
const char font_40[] PROGMEM = { 'n', 5, 0x3F, 0x10, 0x20, 0x20, 0x1F}; //  n
const char font_41[] PROGMEM = { 'o', 5, 0x0E, 0x11, 0x11, 0x11, 0x0E}; //  o
const char font_42[] PROGMEM = { 'p', 5, 0x3F, 0x24, 0x24, 0x24, 0x18}; //  p
const char font_43[] PROGMEM = { 'q', 5, 0x10, 0x28, 0x28, 0x18, 0x3F}; //  q
const char font_44[] PROGMEM = { 'r', 5, 0x1F, 0x08, 0x10, 0x10, 0x08}; //  r
const char font_45[] PROGMEM = { 's', 5, 0x09, 0x15, 0x15, 0x15, 0x02}; //  s
const char font_46[] PROGMEM = { 't', 5, 0x20, 0xFE, 0x21, 0x01, 0x02}; //  t
const char font_47[] PROGMEM = { 'u', 5, 0x1E, 0x01, 0x01, 0x02, 0x1F}; //  u
const char font_48[] PROGMEM = { 'v', 5, 0x1C, 0x02, 0x01, 0x02, 0x1C}; //  v
const char font_49[] PROGMEM = { 'w', 5, 0x1E, 0x01, 0x0E, 0x01, 0x1E}; //  w
const char font_50[] PROGMEM = { 'x', 5, 0x11, 0x0A, 0x04, 0x0A, 0x11}; //  x
const char font_51[] PROGMEM = { 'y', 5, 0x00, 0x39, 0x05, 0x05, 0x3E}; //  y
const char font_52[] PROGMEM = { 'z', 5, 0x11, 0x13, 0x15, 0x19, 0x11}; //  z
const char font_53[] PROGMEM = { '0', 5, 0x7E, 0x89, 0x91, 0xA1, 0x7E}; //  0 
const char font_54[] PROGMEM = { '1', 4, 0x00, 0x41, 0xFF, 0x01, 0x00}; //  1
const char font_55[] PROGMEM = { '2', 5, 0x43, 0x85, 0x89, 0x91, 0x61}; //  2
const char font_56[] PROGMEM = { '3', 5, 0x42, 0x81, 0x91, 0x91, 0x6E}; //  3
const char font_57[] PROGMEM = { '4', 5, 0x18, 0x28, 0x48, 0xFF, 0x08}; //  4
const char font_58[] PROGMEM = { '5', 5, 0xF2, 0x91, 0x91, 0x91, 0x8E}; //  5
const char font_59[] PROGMEM = { '6', 5, 0x1E, 0x29, 0x49, 0x89, 0x86}; //  6
const char font_60[] PROGMEM = { '7', 5, 0x80, 0x8F, 0x90, 0xA0, 0xC0}; //  7
const char font_61[] PROGMEM = { '8', 5, 0x6E, 0x91, 0x91, 0x91, 0x6E}; //  8
const char font_62[] PROGMEM = { '9', 5, 0x70, 0x89, 0x89, 0x8A, 0x7C}; //  9	
const char font_63[] PROGMEM = { '?', 5, 0x60, 0x80, 0x8D, 0x90, 0x60}; //  ?
const char font_64[] PROGMEM = { '!', 1, 0xFD, 0x00, 0x00, 0x00, 0x00}; //  !
const char font_65[] PROGMEM = { '@', 5, 0x04, 0x02, 0xFF, 0x02, 0x04}; //  DOWN   (->)
const char font_66[] PROGMEM = { '#', 5, 0x20, 0x40, 0xFF, 0x40, 0x20}; //  UP (<-)
const char font_67[] PROGMEM = { '&', 5, 0x76, 0x89, 0x95, 0x62, 0x05}; //  &
const char font_68[] PROGMEM = { '(', 4, 0x00, 0x3C, 0x42, 0x81, 0x00}; //  (
const char font_69[] PROGMEM = { ')', 4, 0x00, 0x81, 0x42, 0x3C, 0x00}; //  )
const char font_70[] PROGMEM = { '+', 5, 0x08, 0x08, 0x3E, 0x08, 0x08}; //  "+"
const char font_71[] PROGMEM = { '-', 5, 0x08, 0x08, 0x08, 0x08, 0x08}; //  -
const char font_72[] PROGMEM = { '=', 5, 0x14, 0x14, 0x14, 0x14, 0x14}; //  =

const char font_73[] PROGMEM = 
{ '<', 5, 
  0B00011000,
  0B00111100,
  0B01100110,
  0B11000011,
  0B10000001,
  0B00000000,
  0B00000000,
  0B00000000
}; //  R arrow

const char font_74[] PROGMEM = 
{ '>', 5, 
  0B10000001,
  0B11000011,
  0B01100110,
  0B00111100,
  0B00011000,
  0B00000000,
  0B00000000,
  0B00000000
}; //  L arrow


const char font_75[] PROGMEM = { '$', 5, 0x12, 0x2A, 0x7F, 0x2A, 0x24}; //  $
const char font_76[] PROGMEM = { '*', 5, 0x44, 0x02, 0x12, 0x02, 0x44}; //  smile
const char font_77[] PROGMEM = { '`', 5, 0xFF, 0xFF, 0xFF, 0xFF, 0xFF}; //  5x8 block
const char font_78[] PROGMEM = { '.', 2, 0x03, 0x03, 0xFF, 0xFF, 0xFF}; //  .
const char font_79[] PROGMEM = { '°', 2, 0x60, 0x60, 0xFF, 0xFF, 0xFF}; //  Deg Symbol
const char font_80[] PROGMEM = { ':', 2, 0x66, 0x66, 0xFF, 0xFF, 0xFF}; //  :
const char font_81[] PROGMEM = { '§', 5, 0xFF, 0x95, 0x08, 0x95, 0xFF}; // [x]
const char font_82[] PROGMEM = { '%', 5, 0xFF, 0x81, 0x00, 0x81, 0xFF}; // [ ]
const char font_83[] PROGMEM = { '|', 1 ,0xFF}; // |

#define FONT_SIZE 84
PGM_P const font[ FONT_SIZE ] PROGMEM = { font_0, font_1, font_2, font_3, font_4, font_5, font_6, font_7, font_8, font_9, font_10, font_11, font_12, font_13, font_14, font_15, font_16, font_17, font_18, font_19, font_20, font_21, font_22, font_23, font_24, font_25, font_26, font_27, font_28, font_29, font_30, font_31, font_32, font_33, font_34, font_35, font_36, font_37, font_38, font_39, font_40, font_41, font_42, font_43, font_44, font_45, font_46, font_47, font_48, font_49, font_50, font_51, font_52, font_53, font_54, font_55, font_56, font_57, font_58, font_59, font_60, font_61, font_62, font_63, font_64, font_65, font_66, font_67, font_68, font_69, font_70, font_71, font_72, font_73, font_74, font_75, font_76, font_77, font_78, font_79, font_80, font_81, font_82, font_83 };
