jh-elec/SuperClokk/(commit log)

2018-09-05 Wenn das Datum gescrollt wird, war bei der "KW" ( Kalenderwoche ) ein paar Leerzeichen zu wenig.. Diese wurden ergänzt
2018-09-10 Umrechnung der Übergabeparameter für die Funktion -> scrollDate(..) geändert.
2018-09-11 - Bug bei beim ablegen der EEProm Daten nach dem Sync. behoben. - Bug beim ändern der Helligkeit behoben.
    [Super_Clokk.c]
2018-09-13 Treiber für die Echtzeituhr angepasst
